AVargas-C/embedded-ecg-gating-system/documentation/RETO_Presentacion_Final.pdf

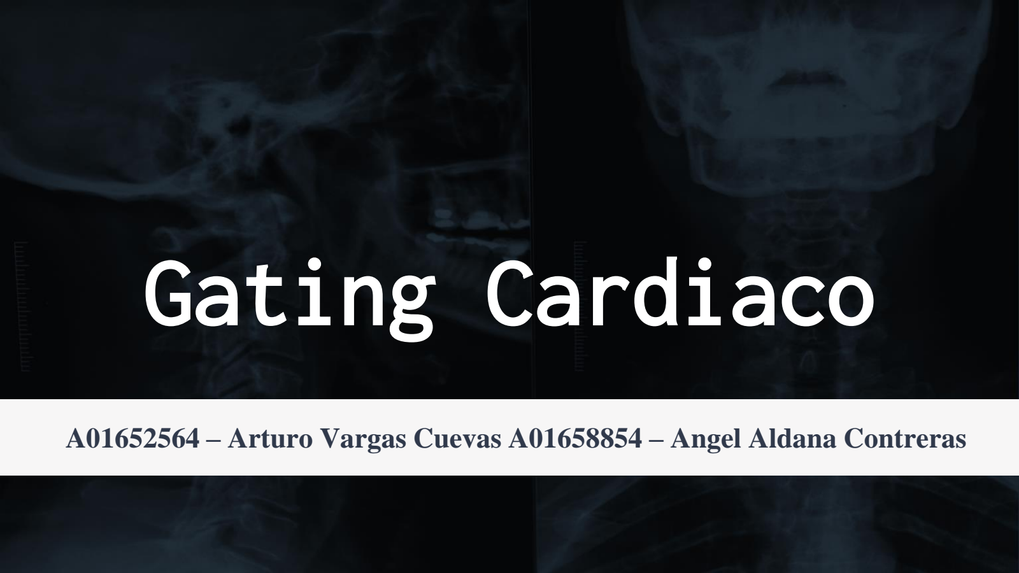
[picture p63: page 1]

# Gating Cardiaco

# A01652564 – Arturo Vargas Cuevas A01658854 – Angel Aldana Contreras

# Tabla de contenidos

- ó

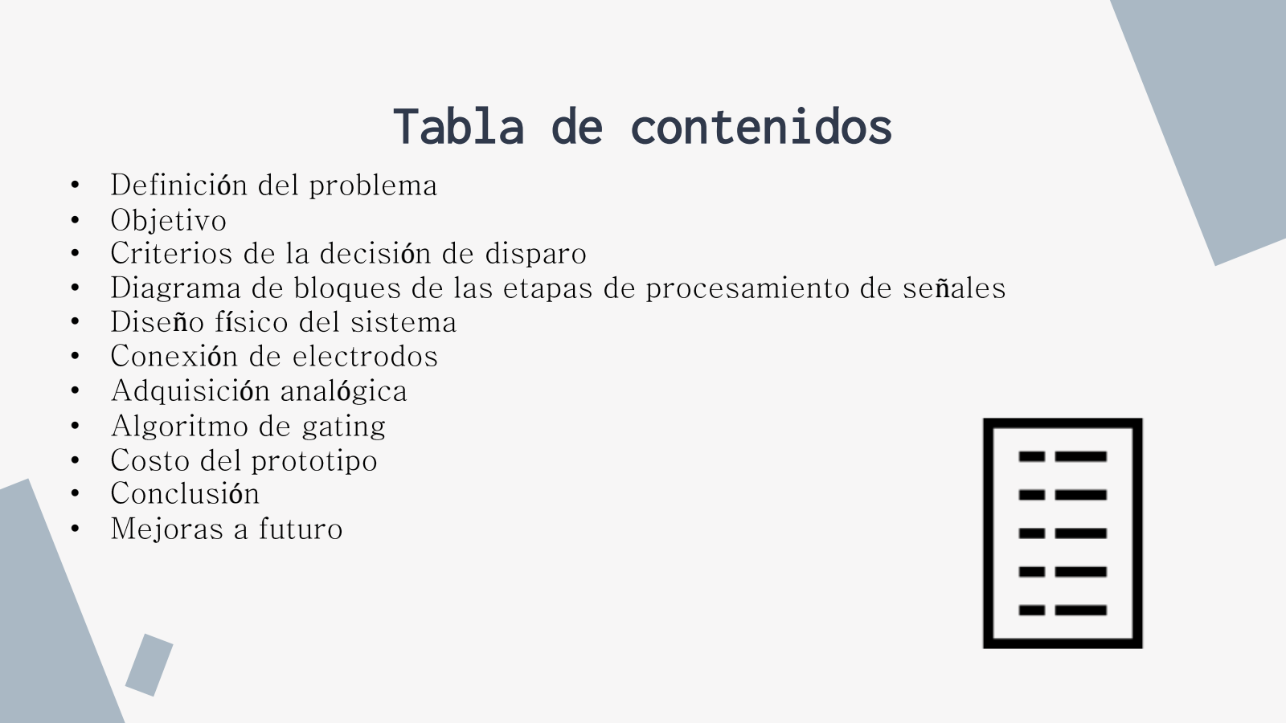
[picture p64: page 2]

•
- ó
- ñ
- | ñ | í
- ó
- | ó | ó
•
•
- ó
•

- Emitir un haz de radiación a la región torácica presenta un reto enorme, ya que se encuentra en constante movimiento.
- Es de suma importancia no afectar el tejido sano.
- El tamaño de la zona a realizar la ablación es una superficie muy reducida.
- La zona objetivo se desplaza con cada movimiento.

# DEFINICIÓN DEL PROBLEMA

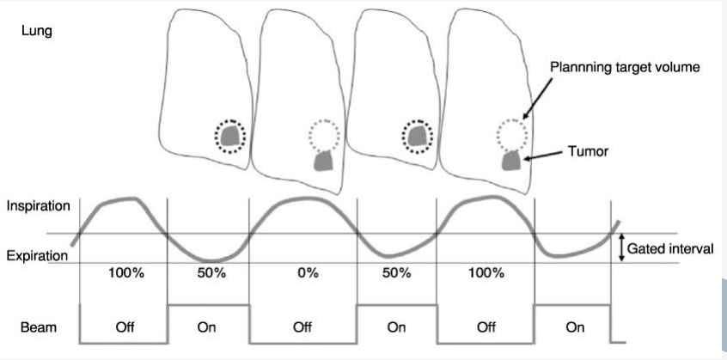
[picture p65: figure]

Utilizar técnicas de acondicionamiento y procesamiento digital de señales,

# para diseñar un algoritmo de disparo estilo Gating “gatilleo” para la administración segura de radiación y minimizar la exposición a los tejidos

sanos.

# Objetivo

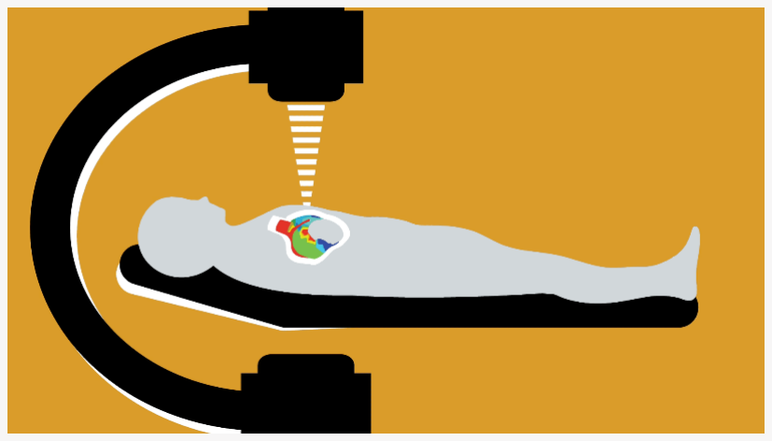
[picture p66: figure]

# Criterios de la decisión de disparo

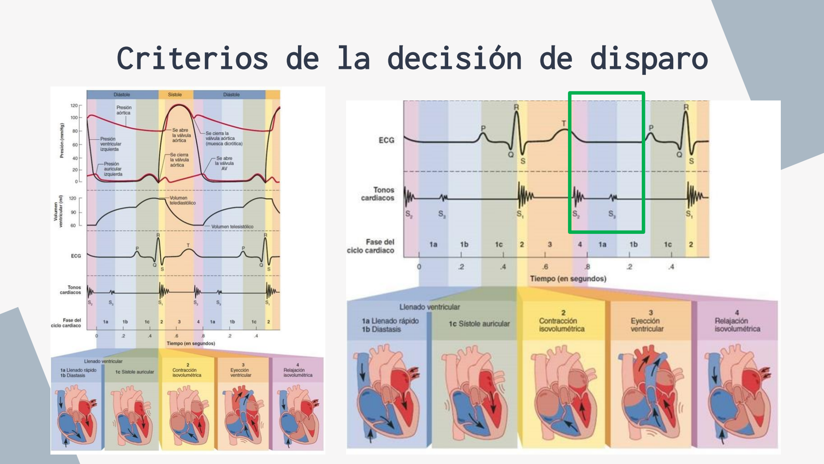
[picture p67: page 5]

# Diagrama de

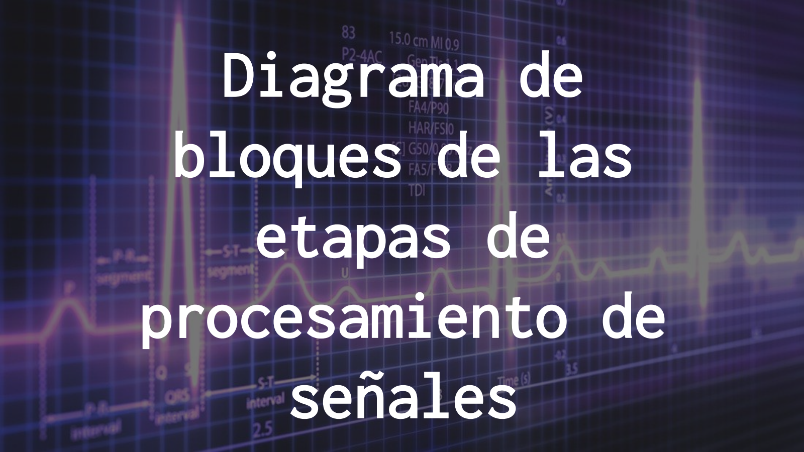
[picture p68: page 6]

# bloques de las etapas de procesamiento de señales

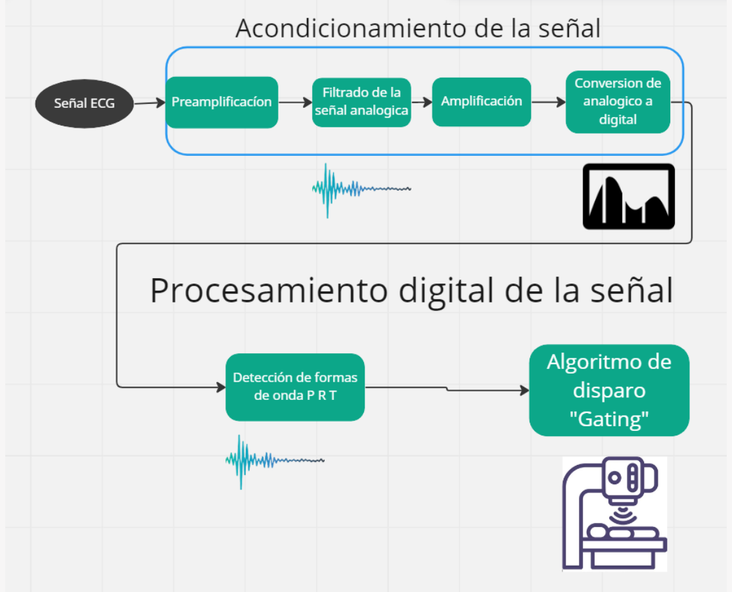
[picture p69: page 7]
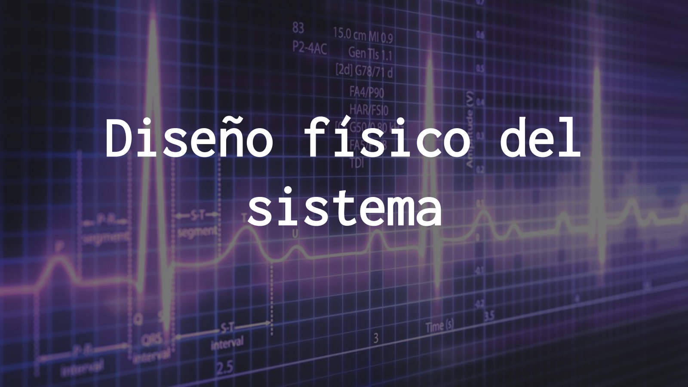
[picture p70: page 8]

# Diseño físico del sistema

# Diseño de la adquisición y filtrado


# Diseño de la alimentación

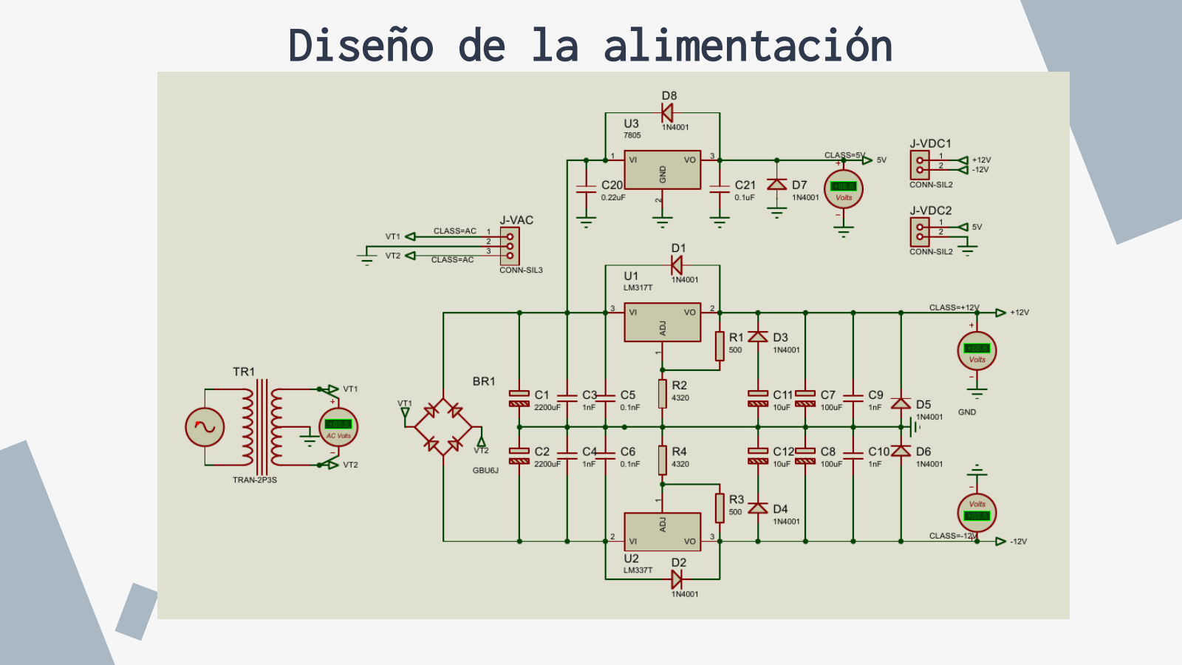
[picture p71: page 10]

# Diseño de la PCB


# Diseño 3D del enclosure

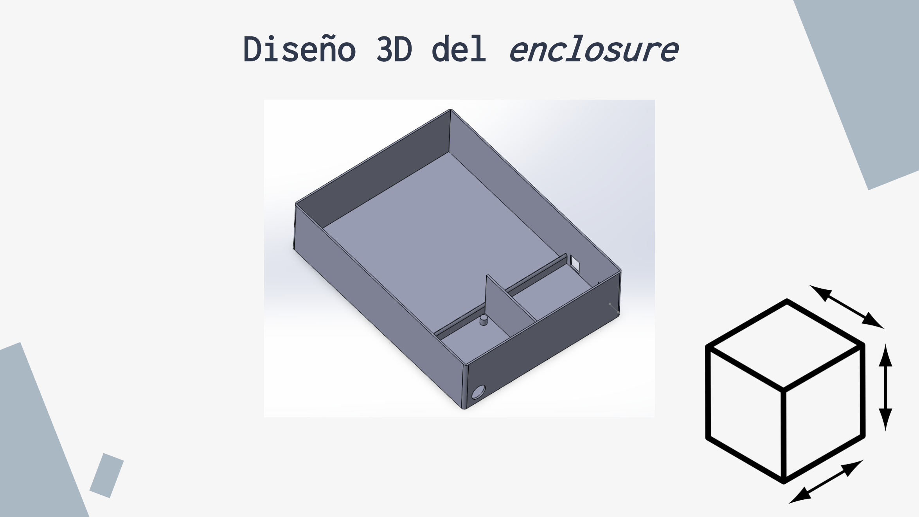
[picture p72: page 12]

# Foto del SOLIDWORKS

# Justificación de la plataforma de desarrollo

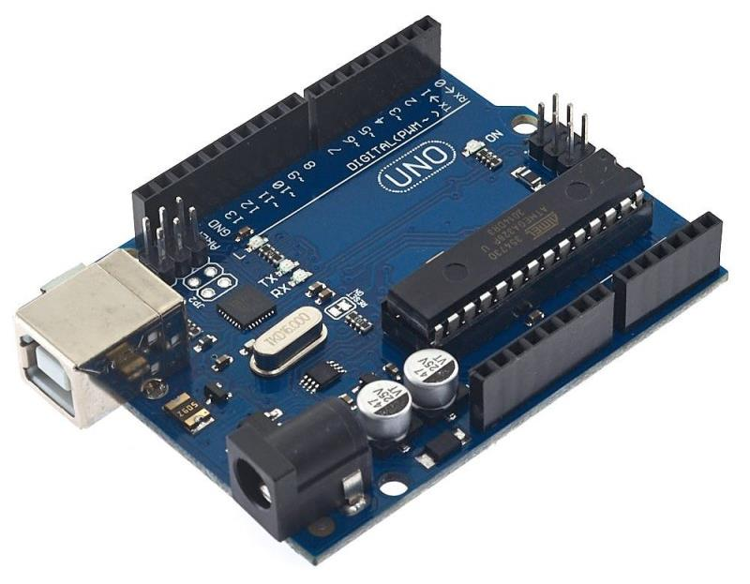
[picture p73: figure]

# Arduino Uno @ 16MHz :

# 10 bits

0-5V

# Fs = 9,615 Hz

# Comunicación serial

# Desafios encontrados:

# La comunicación serial reduce la

# Fs de 6.5 Khz a 1.1 - 1.3kHz

# El ADC del Arduino que disponíamos leía de 0.6V –

4.470 V

# Rango del ADC = 3.8 V

# Diseño final

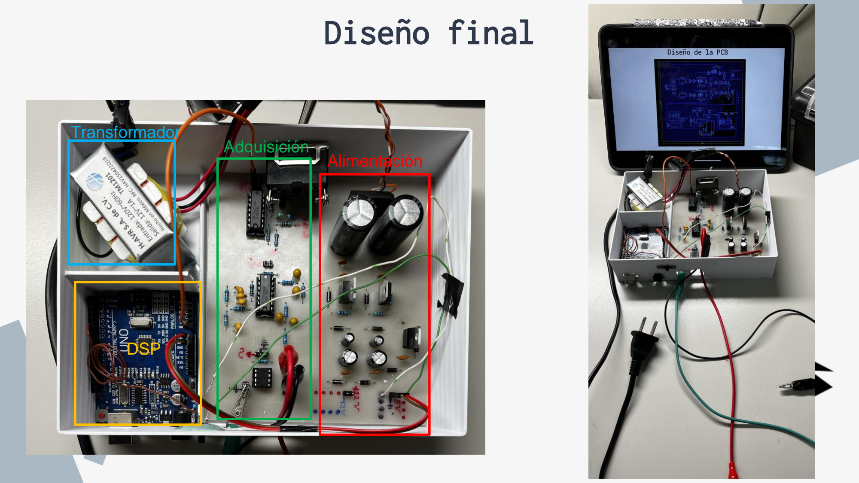
[picture p74: page 14]

# Transformador Adquisición Alimentación

# DSP

# Prestaciones del diseño

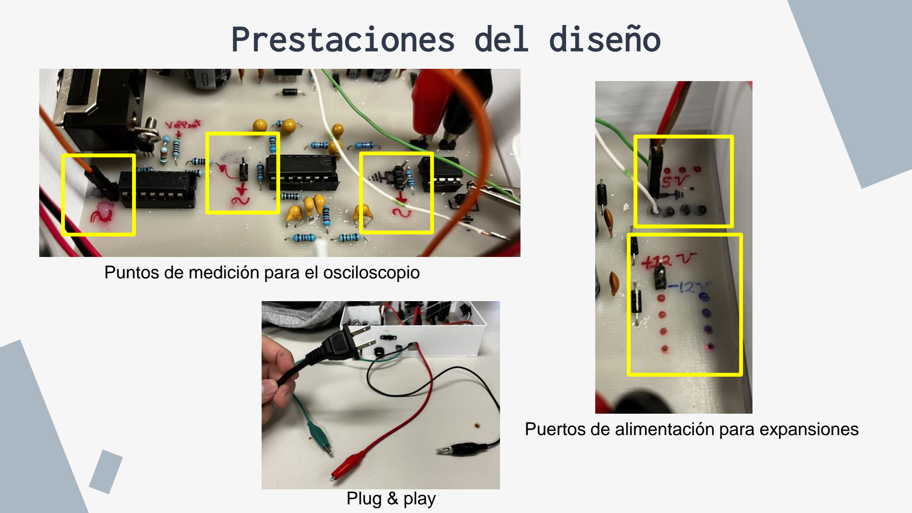
[picture p75: page 15]

# Puntos de medición para el osciloscopio

# Puertos de alimentación para expansiones

# Plug & play

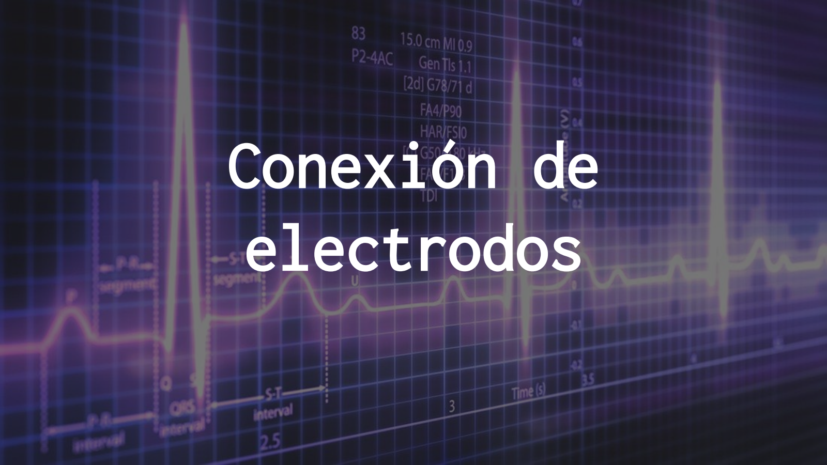
[picture p76: page 16]

# Conexión de electrodos

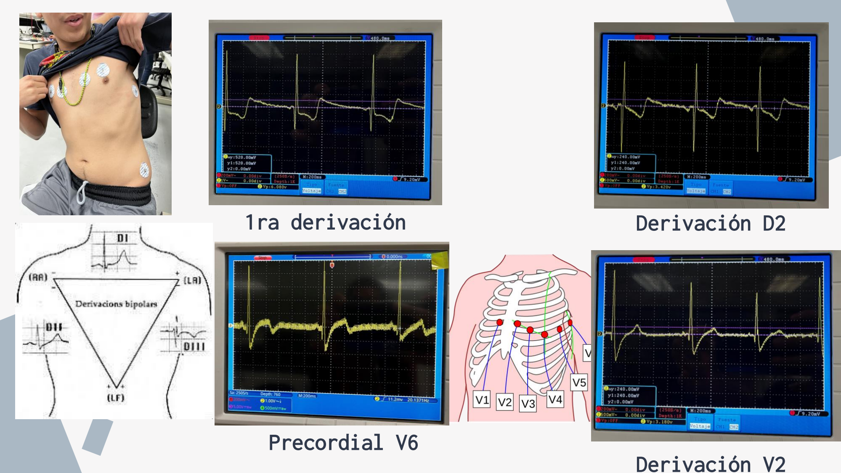
[picture p77: page 17]

1ra derivación | Derivación D2

# Precordial V6 Derivación V2

# Decisión final


# Adquisición

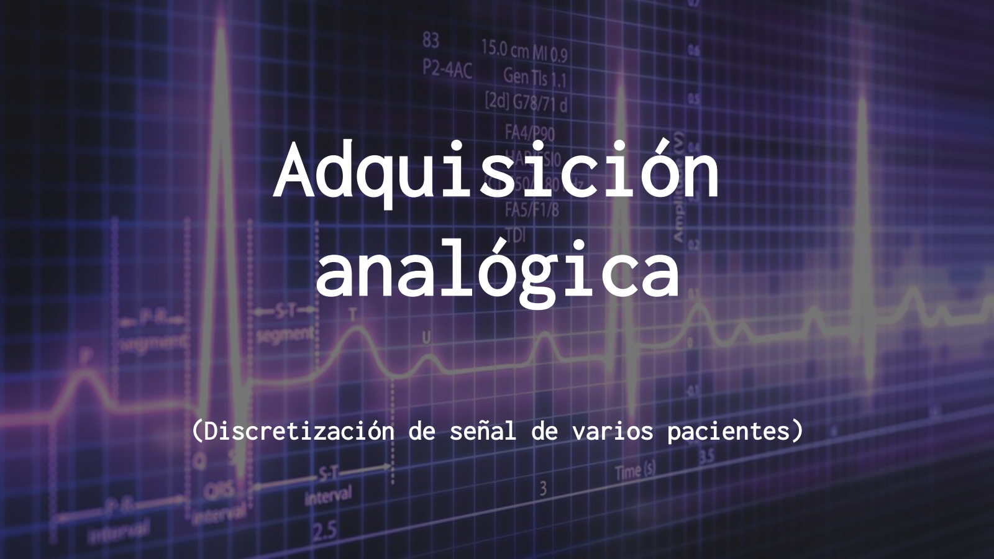
[picture p78: page 19]

# analógica

# (Discretización de señal de varios pacientes)

# Pruebas

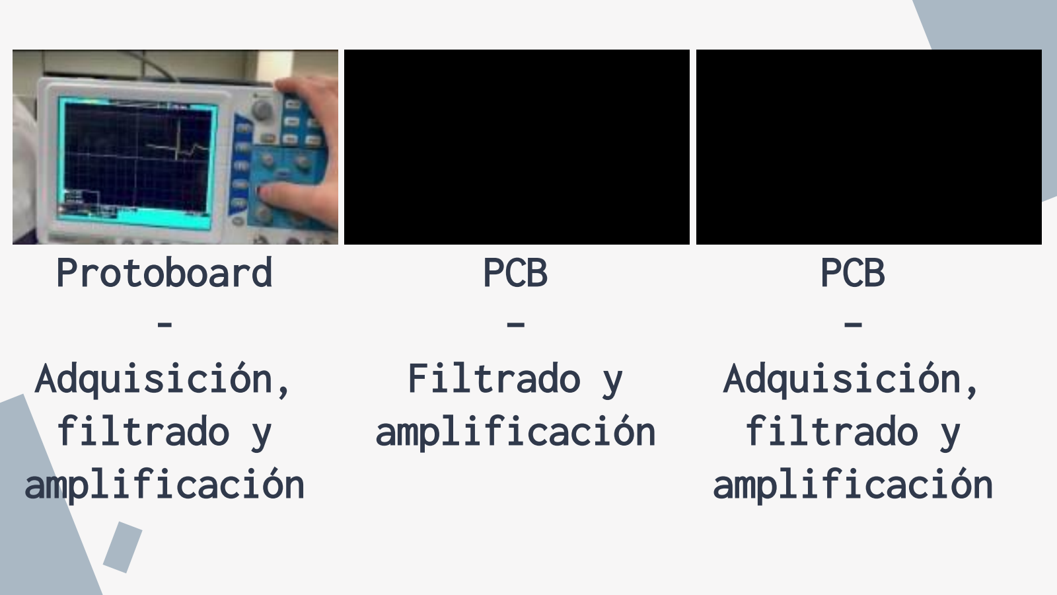
[picture p79: page 21]

# Protoboard

Adquisición,

# filtrado y amplificación

# PCB

–

# Filtrado y amplificación

# PCB

–
Adquisición,

# filtrado y amplificación

# Resultados de la discretización

# Sujeto 1 – Hombre 22 años. Saludable

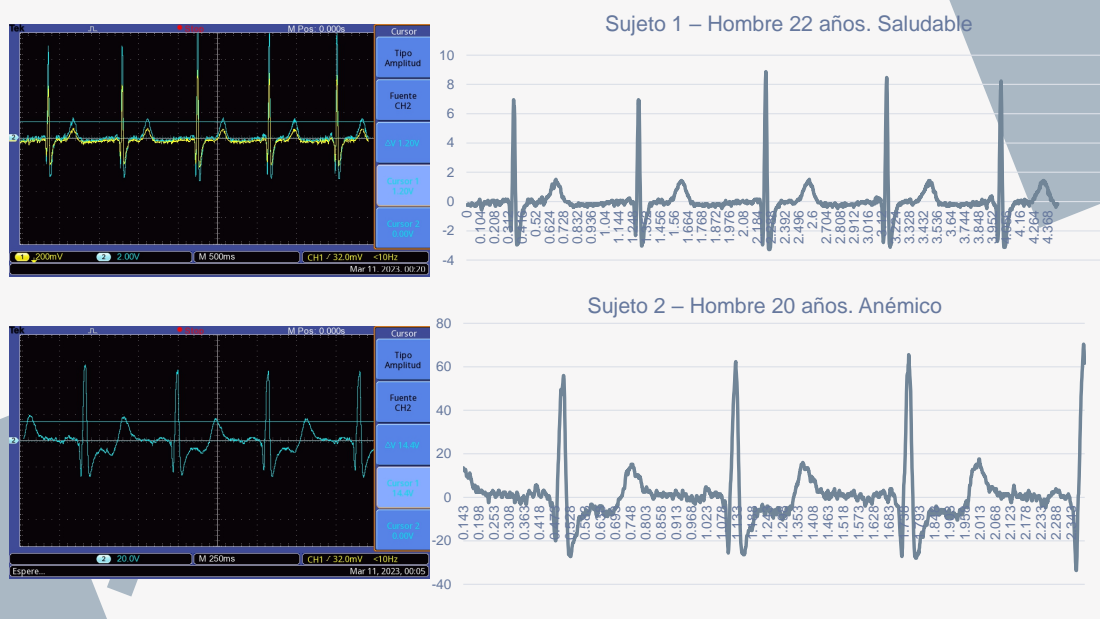
[picture p80: page 23]

Sujeto 2 – Hombre 20 años. Anémico

# Sujeto 3 – Mujer 20 años. Saludable

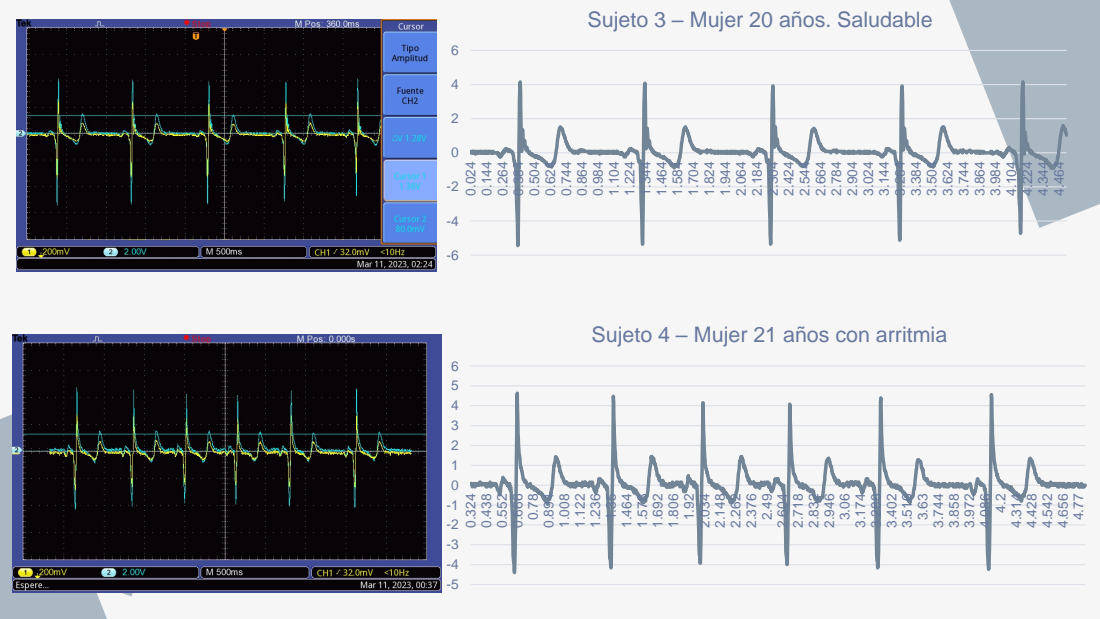
[picture p81: page 24]

Sujeto 4 – Mujer 21 años con arritmia

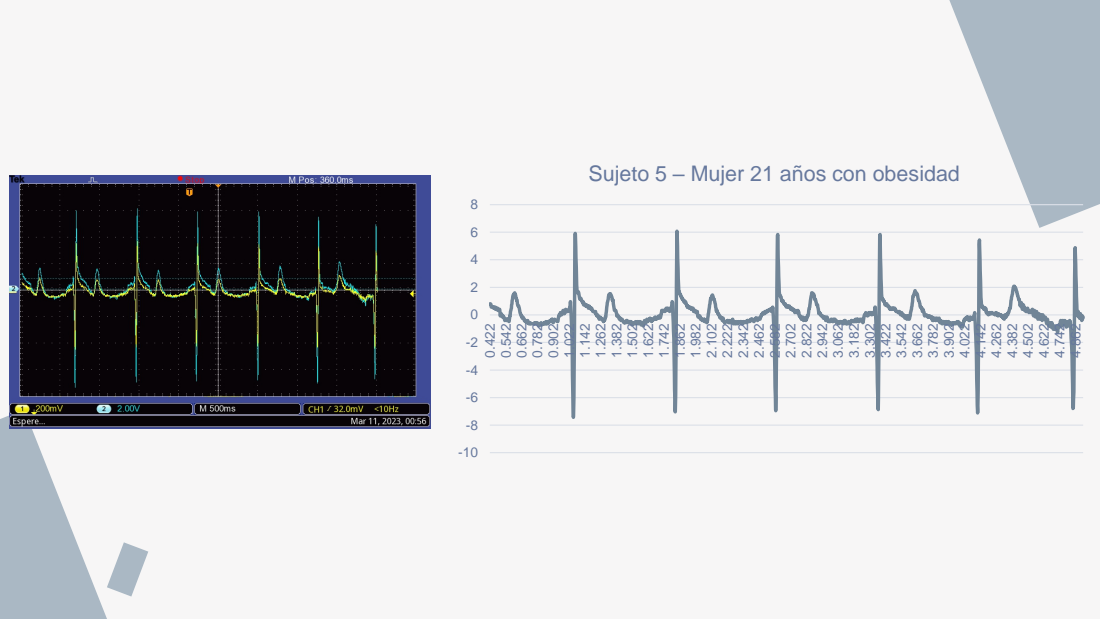
[picture p82: page 25]

Sujeto 5 – Mujer 21 años con obesidad

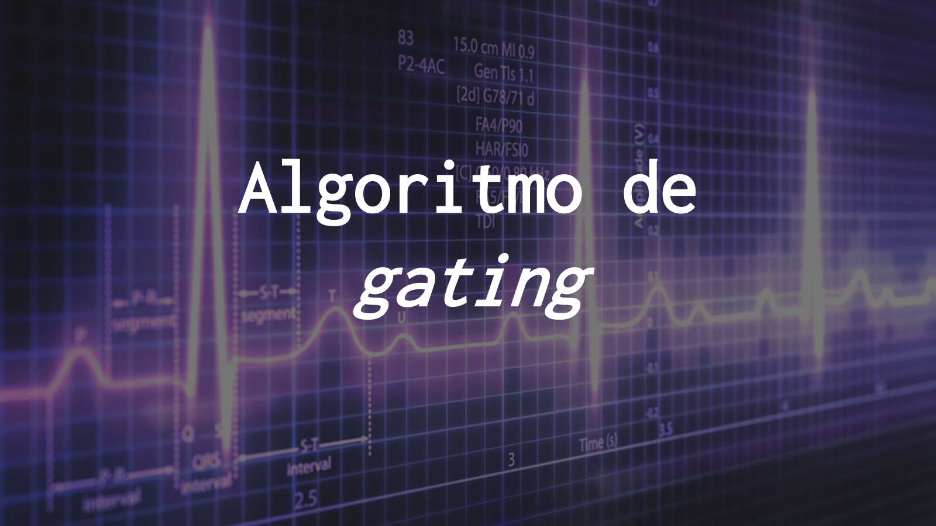
[picture p83: page 26]

# Algoritmo de gating

# Pasos en el diseño del algoritmo

# - Switch de inicio de medición

# - Periodo de adaptación

# - Detección de R - Detección de T - Detección de P - Disparo de gating

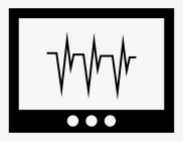
[picture p84: figure]

# - Fs = 6.5 kHz - Retrazo desde la adquisición al disparo: 0.3 – 0.4 ms

# Disparo de T & P en señal simulada

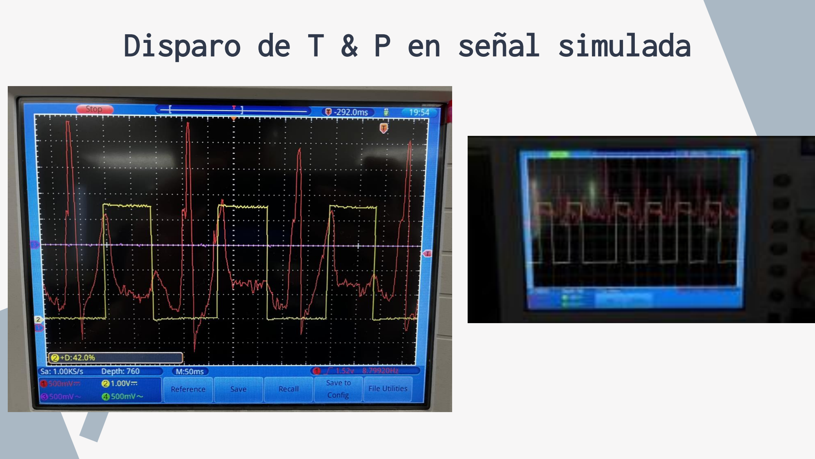
[picture p85: page 28]

# Detección de ondas R & T in vivo

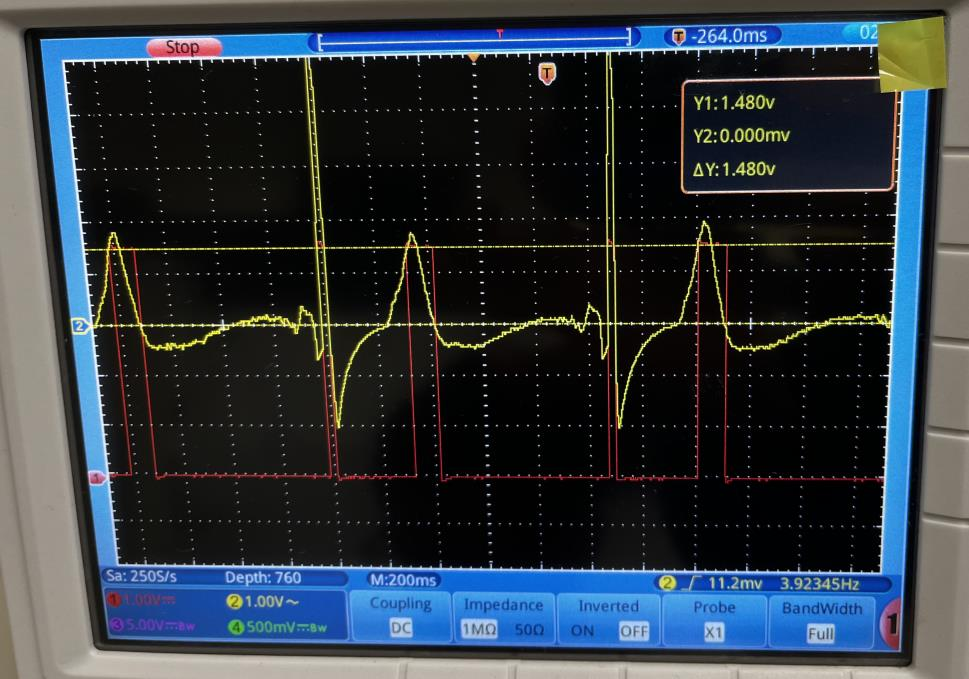
[picture p86: figure]
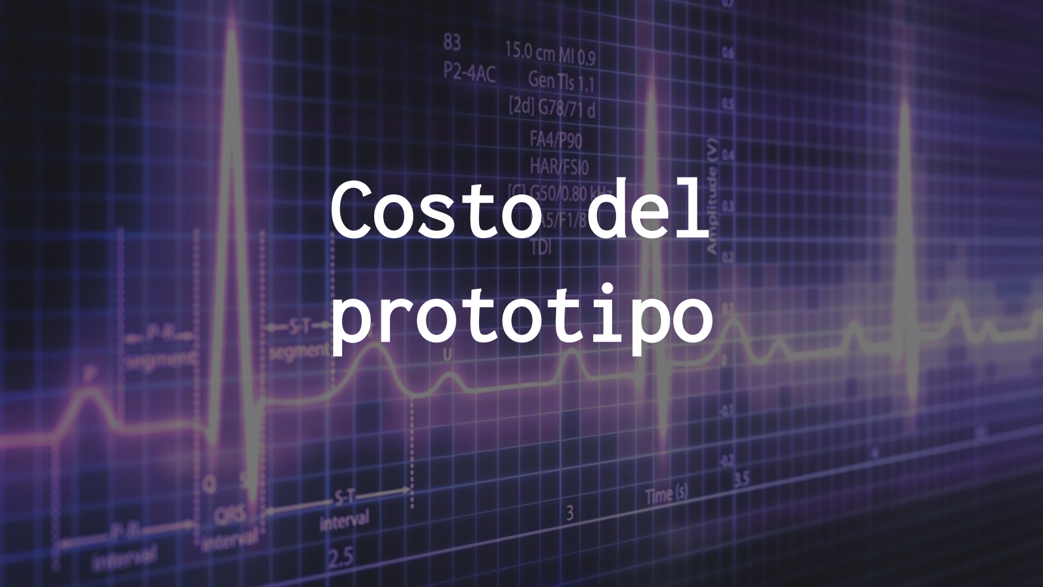
[picture p87: page 30]

# Costo del prototipo

# Lista de materiales

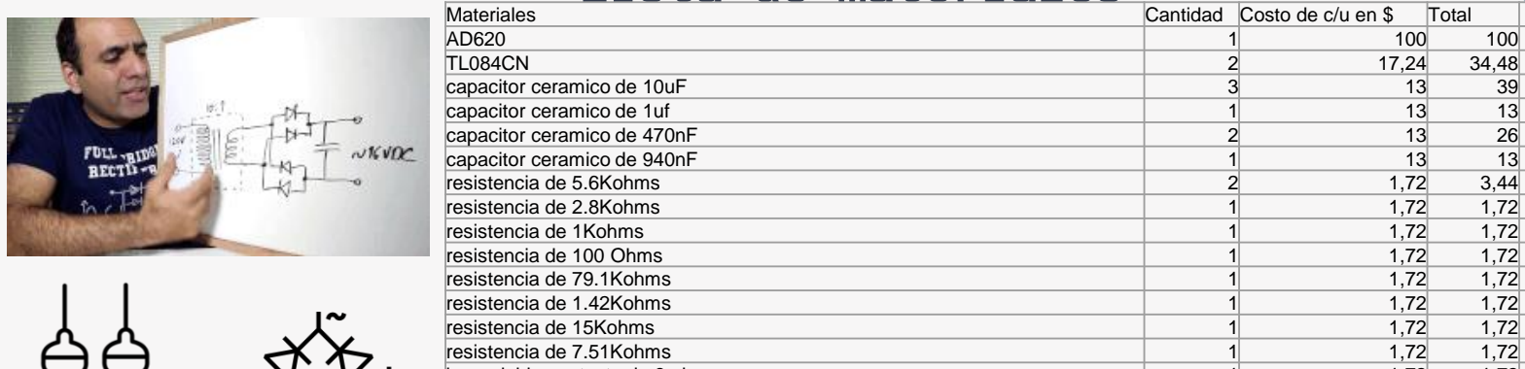
[picture p88: figure]
Materiales; Cantidad; Costo de c/u en $; Total; capacitor ceramico de 10uF; capacitor ceramico de 1uf; capacitor ceramico de 470nF; capacitor ceramico de 940nF; resistencia de 5.6Kohms; resistencia de 2.8Kohms; resistencia de 1Kohms; resistencia de 100 Ohms; resistencia de 79.1Kohms; resistencia de 1.42Kohms; resistencia de 15Kohms; resistencia de 7.51Kohms
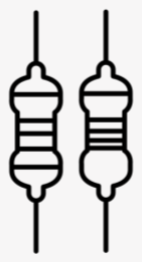
[picture p89: figure]
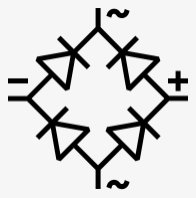
[picture p90: figure]

base doble contacto de 8 pins | 1 | 1,72 | 1,72
base doble contacto de 16 pins | 2 | 3,02 | 6,04
conecto header 40 terminales 1 linea | 1 | 4,3 | 4,3
Puente rectificador en liena 600V 8A | 1 | 20,7 | 20,7
REGULADOR DE VOLTAJE AJUSTABLE 1.2-37V 1.5A | 1 | 9,48 | 9,48
REGULADOR DE VOLTAJE POSITIVO 5V 1A | 1 | 7,33 | 7,33
REGULADOR DE VOLTAJE AJUSTABLE -1.2a-37V 1.5A | 1 | 28,45 | 28,45
DIODO RECTIFICADOR 50V 1A | 8 | 0,85 | 6,8

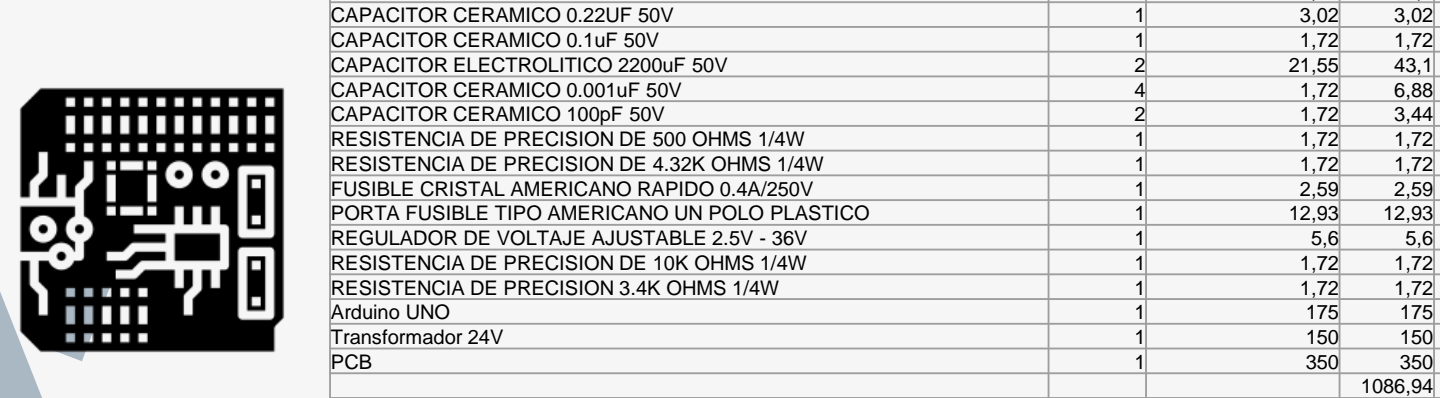
[picture p91: figure]
CAPACITOR CERAMICO 0.22UF 50V; CAPACITOR CERAMICO 0.1uF 50V; CAPACITOR ELECTROLITICO 2200uF 50V; CAPACITOR CERAMICO 0.001uF 50V; CAPACITOR CERAMICO 100pF 50V; FUSIBLE CRISTAL AMERICANO RAPIDO 0.4A/250V; Arduino UNO; Transformador 24V; PCB

RESISTENCIA DE PRECISION DE 500 OHMS 1/4W | 1 | 1,72 | 1,72
RESISTENCIA DE PRECISION DE 4.32K OHMS 1/4W | 1 | 1,72 | 1,72
PORTA FUSIBLE TIPO AMERICANO UN POLO PLASTICO | 1 | 12,93 | 12,93
REGULADOR DE VOLTAJE AJUSTABLE 2.5V - 36V | 1 | 5,6 | 5,6
RESISTENCIA DE PRECISION DE 10K OHMS 1/4W | 1 | 1,72 | 1,72
RESISTENCIA DE PRECISION 3.4K OHMS 1/4W | 1 | 1,72 | 1,72

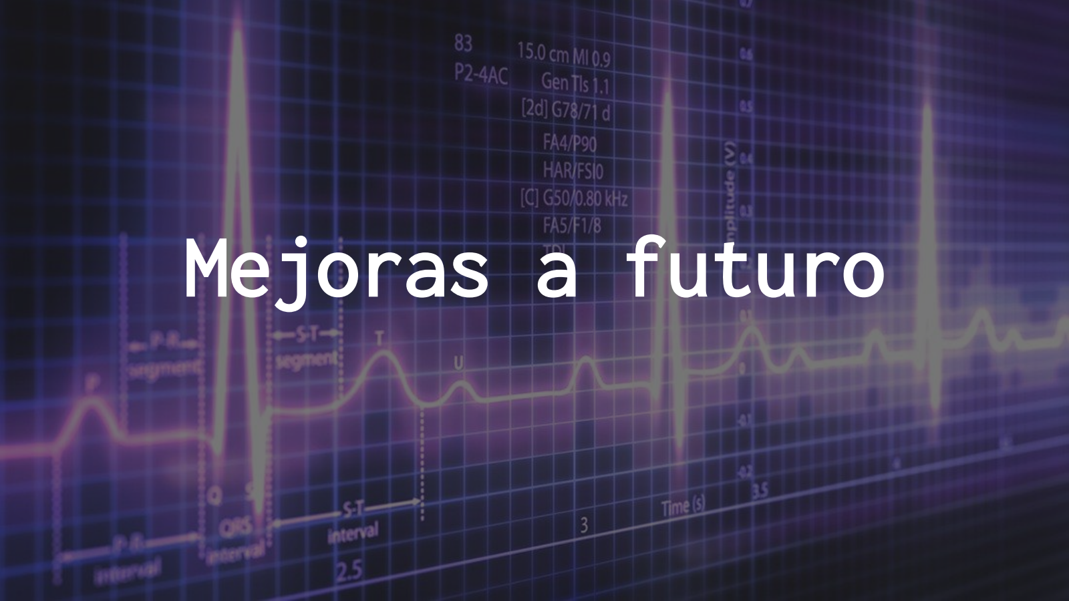
[picture p92: page 32]

# Mejoras a futuro

# - Cambio a fuente conmutada

# - Uso de optoacoplador

# - Jaula de Faraday

# - Validar el sistema con pacientes que sufren arritmia

# y generar una Matriz de confusión

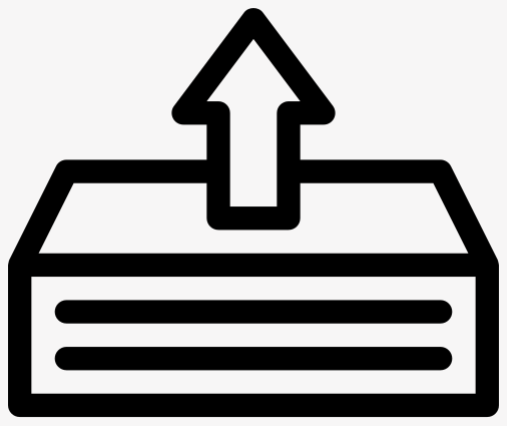
[picture p93: figure]
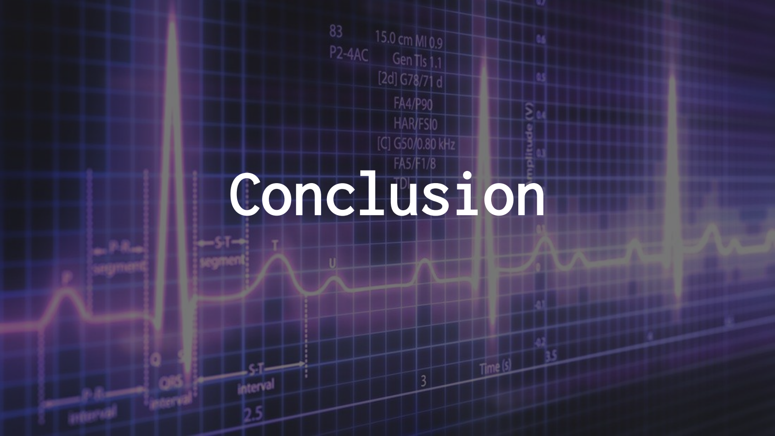
[picture p94: page 34]

# Conclusion

## - Nima Aalizade (2023). ECG P QRS T wave detecting matlab

code (https://www.mathworks.com/matlabcentral/fileexchange/66098-ecg-p-qrs-t-wave-detecting-matlab-code), MATLAB Central File Exchange. Recuperado March 2, 2023.

- Pan, Jiapu; Tompkins, Willis J. (March 1985). "A Real-Time QRS Detection Algorithm". IEEE Transactions on

## Biomedical Engineering. BME-32 (3): 230–236

- Vázquez-Seisdedos, C. R., Neto, J. E., Marañón Reyes, E. J., Klautau, A., & Limão de Oliveira, R. C. (2011). New approach for T-wave end detection on electrocardiogram: performance in noisy conditions. Biomedical

## engineering online, 10, 77. https://doi.org/10.1186/1475-925X-10-77

- González Barajas, J. E. (2016). Electrocardiograma desde una visión digital. Universidad Santo Tomas.
- Köhler, B.-U., Hennig, C., & Orglmeister, R. (n.d.). The principles of software QRS detection reviewing and comparing algorithms for detecting this important ECG waveform. Cornell.edu. Retrieved March 2, 2023, from

## https://people.ece.cornell.edu/land/courses/ece5030/labs/s2013/QRS_detect_review.pdf

- Rojas Jiménez, R. I., Muñoz Diosdado, A., & Zamora Justo, J. A. (n.d.). Detector de picos de ECG y algoritmo

## de análisis de forma de onda. Ipn.Mx. Retrieved March 2, 2023, from https://www.esfm.ipn.mx/assets/files/esfm/docs/RNAFM/articulos-2020/XXVRNAFM076.pdf

# Referencias
