AVargas-C/embedded-ecg-gating-system/PCB/PCB_ECG_design/ComprasAG.xlsx

 | 1 | 8P | BASE DOBLE CONTACTO PARA CI 8 PINS | https://www.agelectronica.com/detalle.php?p=8P
 | 2 | 16P | BASE DOBLE CONTACTO PARA CI 16 PINES | https://www.agelectronica.com/detalle.php?p=16P
 | 1 | HEADER-1 | CONECTOR HEADER 40 TERMINALES 1 LINEA | https://www.agelectronica.com/detalle.php?p=HEADER-1
 | 1 | HEADER-1AR | CONECTOR HEADER 36 TERMINALES 1 LINEA ANGULO RECTO | https://www.agelectronica.com/detalle.php?p=HEADER-1AR
 | 1 | GBU 8J | PUENTE RECTIFICADOR EN LINEA 600V 8A
 | 1 | LM 317T | REGULADOR DE VOLTAJE AJUSTABLE 1.2-37V 1.5A | https://www.agelectronica.com/detalle.php?p=LM%20317T
 | 1 | L 7805CV | REGULADOR DE VOLTAJE POSITIVO 5V 1A | https://www.agelectronica.com/detalle.php?p=L%207805CV
 | 1 | LM 337T | REGULADOR DE VOLTAJE AJUSTABLE -1.2a-37V 1.5A | https://www.agelectronica.com/detalle.php?p=LM%20337T
 | 8 | 1N 4001 | DIODO RECTIFICADOR 50V 1A | https://www.agelectronica.com/detalle.php?p=1N%204001
C20 | 1 | CC-.22/50V-WELSON | CAPACITOR CERAMICO 0.22UF 50V | https://www.agelectronica.com/detalle.php?p=CC-.22/50V-WELSON
C21 | 1 | CC-.1/50V-WELSON | CAPACITOR CERAMICO 0.1uF 50V | https://www.agelectronica.com/detalle.php?p=CC-.1/50V-WELSON
 | 2 | CE-2200/50V-TEAPO | CAPACITOR ELECTROLITICO 2200uF 50V | https://www.agelectronica.com/detalle.php?p=CE-2200/50V-TEAPO
C3,4,9,10 | 4 | CC-.001/50V-WELSON | CAPACITOR CERAMICO 0.001uF 50V | https://www.agelectronica.com/detalle.php?p=CC-.001/50V-WELSON
C5 & C6 | 2 | CC-100/50V-WELSON | CAPACITOR CERAMICO 100pF 50V | https://www.agelectronica.com/detalle.php?p=CC-100/50V-WELSON
 | 1 | RP-500E | RESISTENCIA DE PRECISION DE 500 OHMS 1/4W | https://www.agelectronica.com/detalle.php?p=RP-500E
 | 1 | RP-4K32 | RESISTENCIA DE PRECISION DE 4.32K OHMS 1/4W | https://www.agelectronica.com/detalle.php?p=RP-4K32
 | 4 | FA .4 | FUSIBLE CRISTAL AMERICANO RAPIDO 0.4A/250V | https://www.agelectronica.com/detalle.php?p=FA%20.4
 | 1 | AMPF-1 | PORTA FUSIBLE TIPO AMERICANO UN POLO PLASTICO | https://www.agelectronica.com/detalle.php?p=AMPF-1
 | 1 | TL 431K | REGULADOR DE VOLTAJE AJUSTABLE 2.5V - 36V | https://www.agelectronica.com/detalle.php?p=TL%20431K
 | 1 | RP-10K | RESISTENCIA DE PRECISION DE 10K OHMS 1/4W | https://www.agelectronica.com/detalle.php?p=RP-10K
 | 1 | RP-3K4 | RESISTENCIA DE PRECISION 3.4K OHMS 1/4W | https://www.agelectronica.com/detalle.php?p=RP-3K4
 | 1 | TL 084CN | AMP-OP ENTRADA BI-FET CUADRUPLE | https://www.agelectronica.com/detalle.php?p=TL%20084CN
