AVargas-C/embedded-ecg-gating-system/PCB/PCB_ECG_design/DiagramaAdquisición.PDF

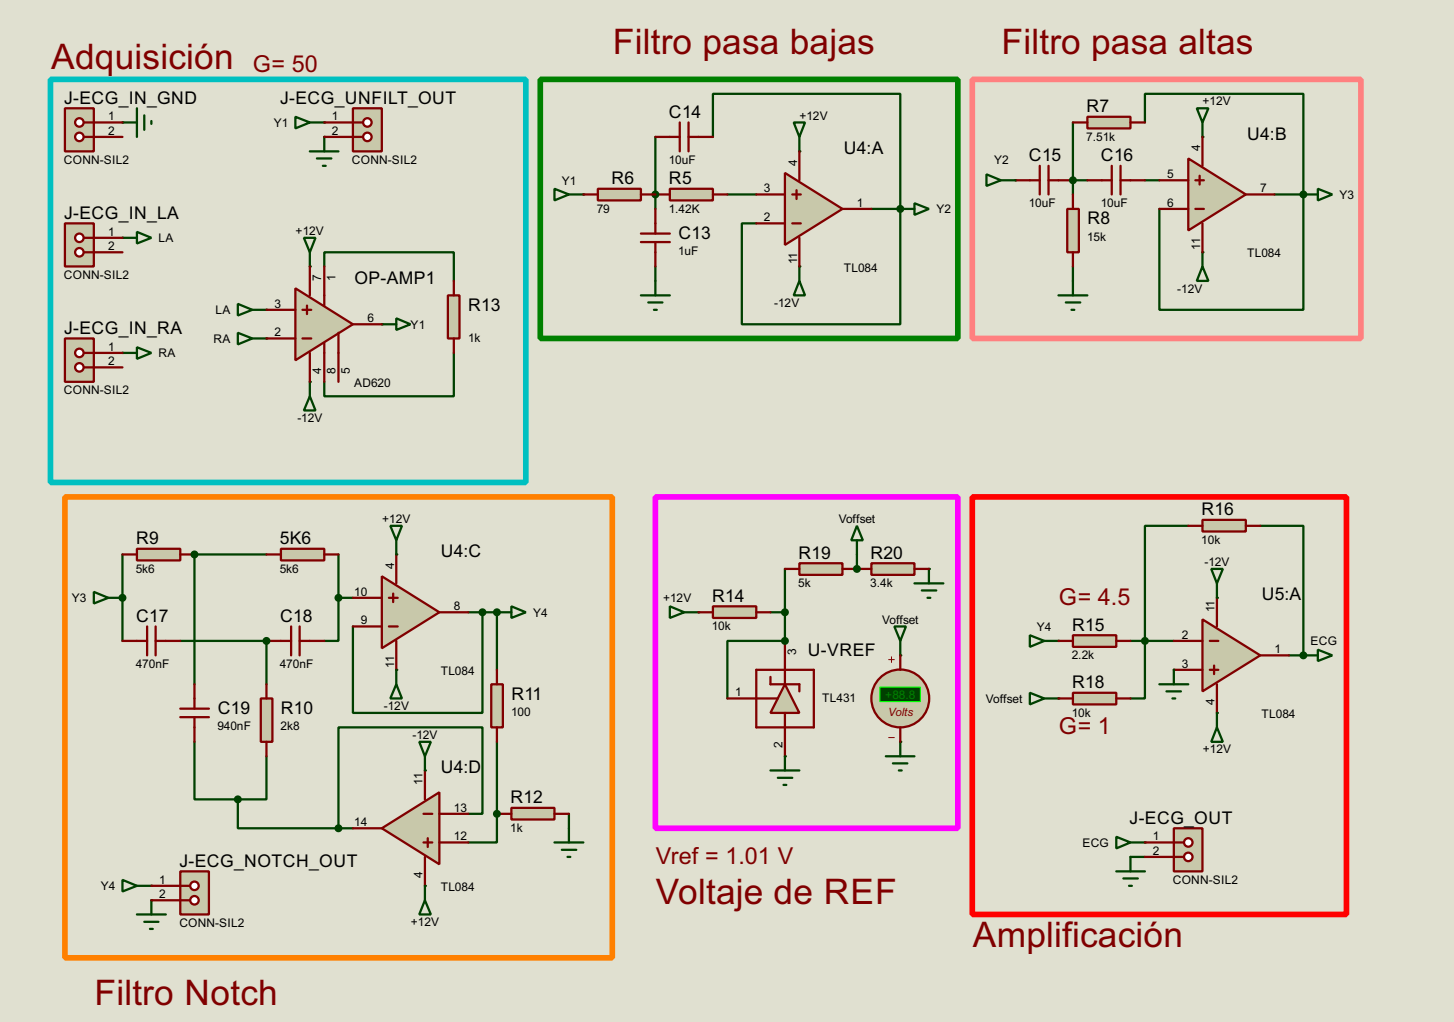
[picture p95: page 1]
