AVargas-C/embedded-ecg-gating-system/PCB/PCB_ECG_design/DiagramaFuente.PDF

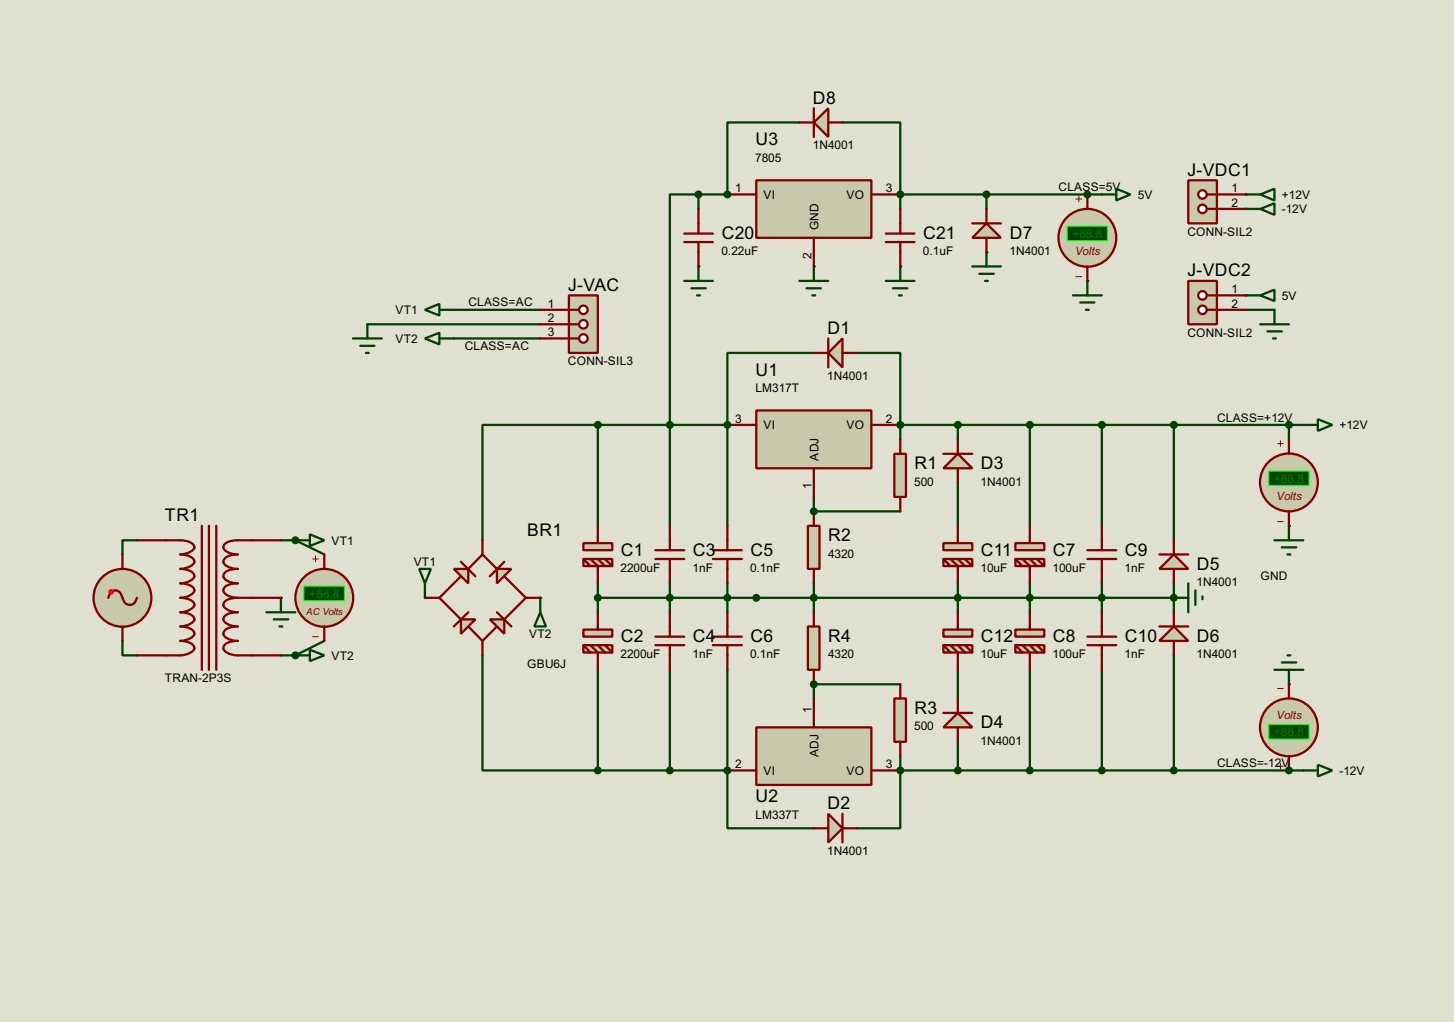
[picture p96: page 1]
