AVargas-C/embedded-ecg-gating-system/(list of files, drawings)

Other design files:
PCB/PCB_analog_filters_desgin/RETO_Proteus1_FiltrosECG.pdsprj
PCB/PCB_ECG_design/RETO_Proteus4_ECG_PCB.pdsprj
PCB/PCB_power_supply_design/RETO_Proteus2_FuenteECG.pdsprj
