AVargas-C/embedded-ecg-gating-system/(commit log)

2023-03-01 feat: add threshold calibration exploration (Phase 1)
2023-03-02 feat: add R-peak detection algorithm (Phase 2)
    Expand from threshold calibration to full R-peak (QRS complex) detection.
    Implements absolute maximum value tracking with adaptive threshold at 75%
    of peak. Adds R-R interval tracking and local peak buffering for heart rate
    estimation. Refines T-wave thresholds to 1.8-2.56V based on empirical testing.
2023-03-06 feat: implement basic threshold detection (Phase 4)
    First production version using simple fixed-voltage threshold (1.46V).
    Reads ECG from pin A0, outputs trigger on pin 6 when sample exceeds
    threshold. No adaptation or peak detection logic. Clean, minimal design.
    [sketch.ino]
2023-03-08 feat: add R-peak detection with self-adjustable thresholds
    Implement adaptive R-peak detection measuring absolute maximum during 5000-sample
    adaptation phase. Calculate R-peak threshold dynamically at 60% of observed max.
    Detect and trigger on R-peaks post-adaptation using conditioned signal range
    (0.61V-4.47V).
2023-03-09 feat: add T-wave detection with empiric thresholds
    Extend R-peak detection with T-wave repolarization peak detection. Expand
    adaptation phase to 30000 samples. Implement empiric T-wave thresholds
    (1.8V-2.56V) and detect local peaks within 500-1000 sample window post-R-peak.
    Fire output on T-wave peak detection.
2023-03-15 docs: add PCB design files for filter, amplifier, and power supply stages
    [ComprasAG.xlsx, RETO_Proteus1_FiltrosECG.pdsprj, RETO_Proteus2_FuenteECG.pdsprj, RETO_Proteus4_ECG_PCB.pdsprj]
