AVargas-C/embedded-ecg-gating-system/pictures/31_first_prototype_protoboard.png

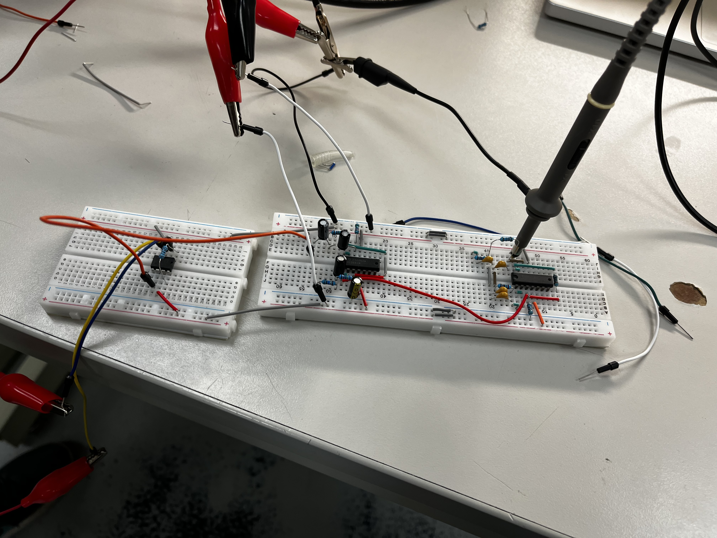
[picture p12: pictures/31_first_prototype_protoboard.png]
pictures/31_first_prototype_protoboard.png
