AVargas-C/embedded-ecg-gating-system/pictures/32_second_prototype_protoboard.png

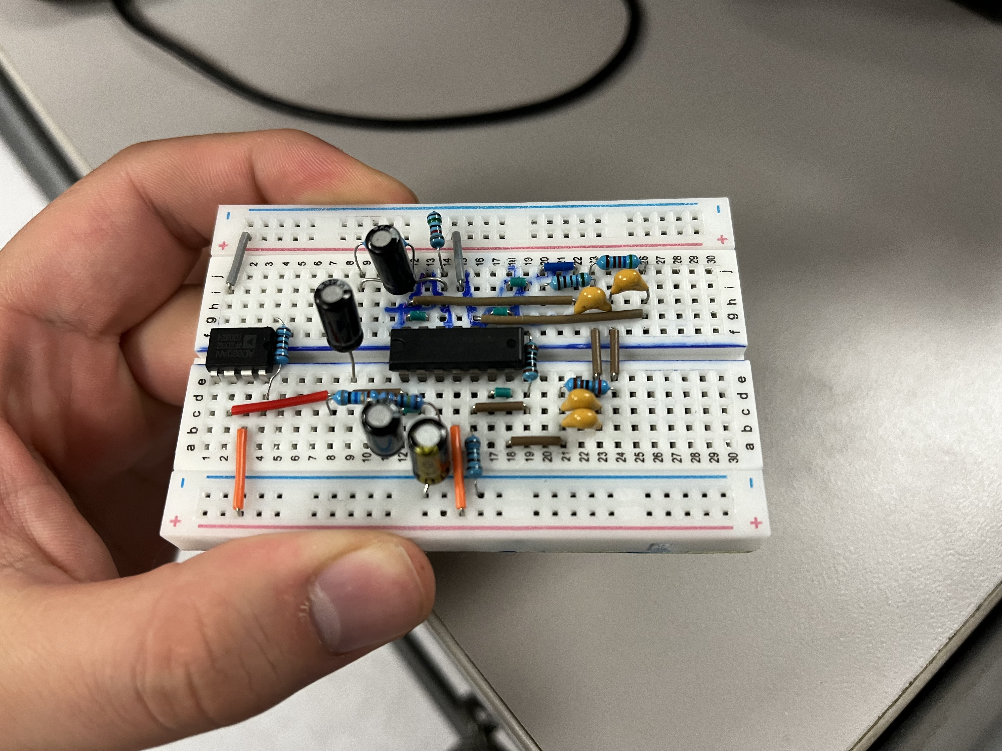
[picture p13: pictures/32_second_prototype_protoboard.png]
pictures/32_second_prototype_protoboard.png
