AVargas-C/embedded-ecg-gating-system/pictures/28_electrodes_first_derivation.png

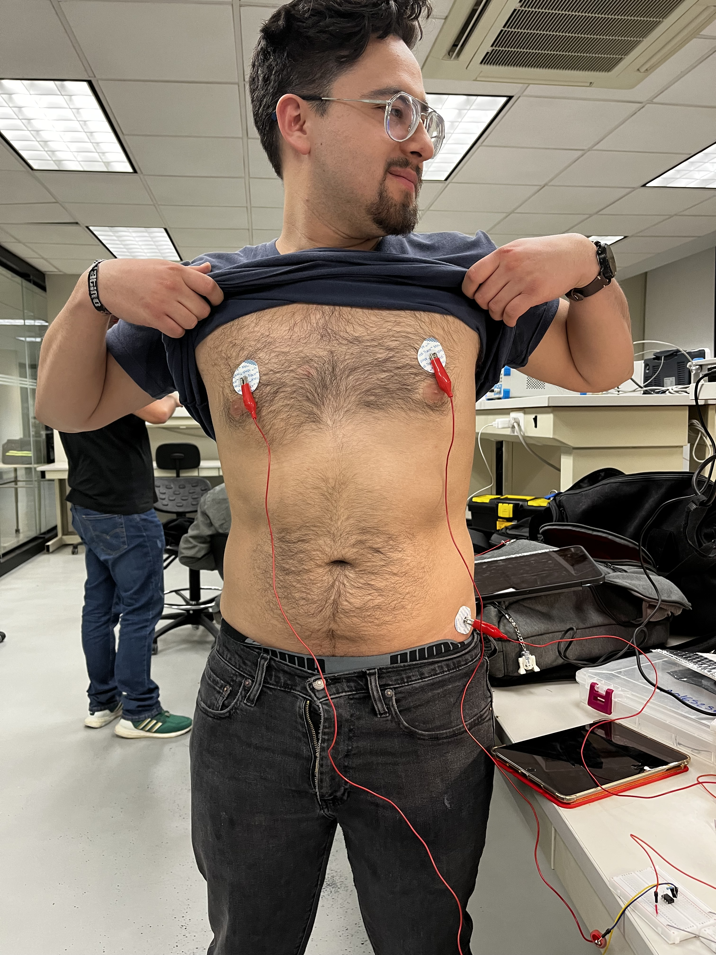
[picture p14: pictures/28_electrodes_first_derivation.png]
pictures/28_electrodes_first_derivation.png
